chipdipru/Nermostat-RDC2-0043/RDC2-0043_BOM.pdf

RDC2-0043 BOM

количество | позиция | наименование | код товара
11 | C1, C2, C6 - C8, C10 - C15 | 0.1мкФ, 50В, 0603 | 226236018
2 | C3, C5 | 2.2мкФ, 10В, 0603 | 964476454
1 | C4 | 0.01 мкФ, 50В, 0603 | 990818187
2 | C9, C16 | 4.7 мкФ, 10 В, тип A | 6038
1 | DA1 | LP2985AIM5-3.3/NOPB | 398602252
1 | DD1 | M95640-WMN6P | 9020005380
1 | DD2 | STM32F042K6T6 | 9000240186
4 | HL2, HL4 - HL6 | TOS-F2101AMG-N-1-HF | 9000473272
1 | HL3 | TO-2013BC-PG | 9000414318
1 | R1 | не устанавливать
12 | R2 - R5, R7 - R13, R25 | 0.063Вт 0603 10 кОм, 5% | 65097
9 | R6, R15 - R22 | 0.063Вт 0603 330 Ом, 5% | 16489
1 | R14 | 0.063Вт 0603 4.7 кОм, 5% | 13832
2 | R23, R24 | 0.063Вт 0603 22 Ом, 5% | 45498
1 | SW1 | не устанавливать
4 | SW2 - SW5 | KLS7-TS3601-4.3-180 (TC-0120) | 9000336835
1 | VD1 | USBLC6-2SC6 | 9000039051
1 | VD2 | MBR0520L | 9000119271
4 | VT1 - VT4 | 2N7002.215 | 2272434975
1 | | KLS1-233-0-0-1-T (Micro USB 5S-B) | 9000144095
1 | | KLS2-300-5.00-03P-2S | 9000329448
1 | | Печатная плата RDC2-0043 | 9000508597
