chipdipru/Nermostat-RDC2-0043/RDC2-0043_sch.pdf

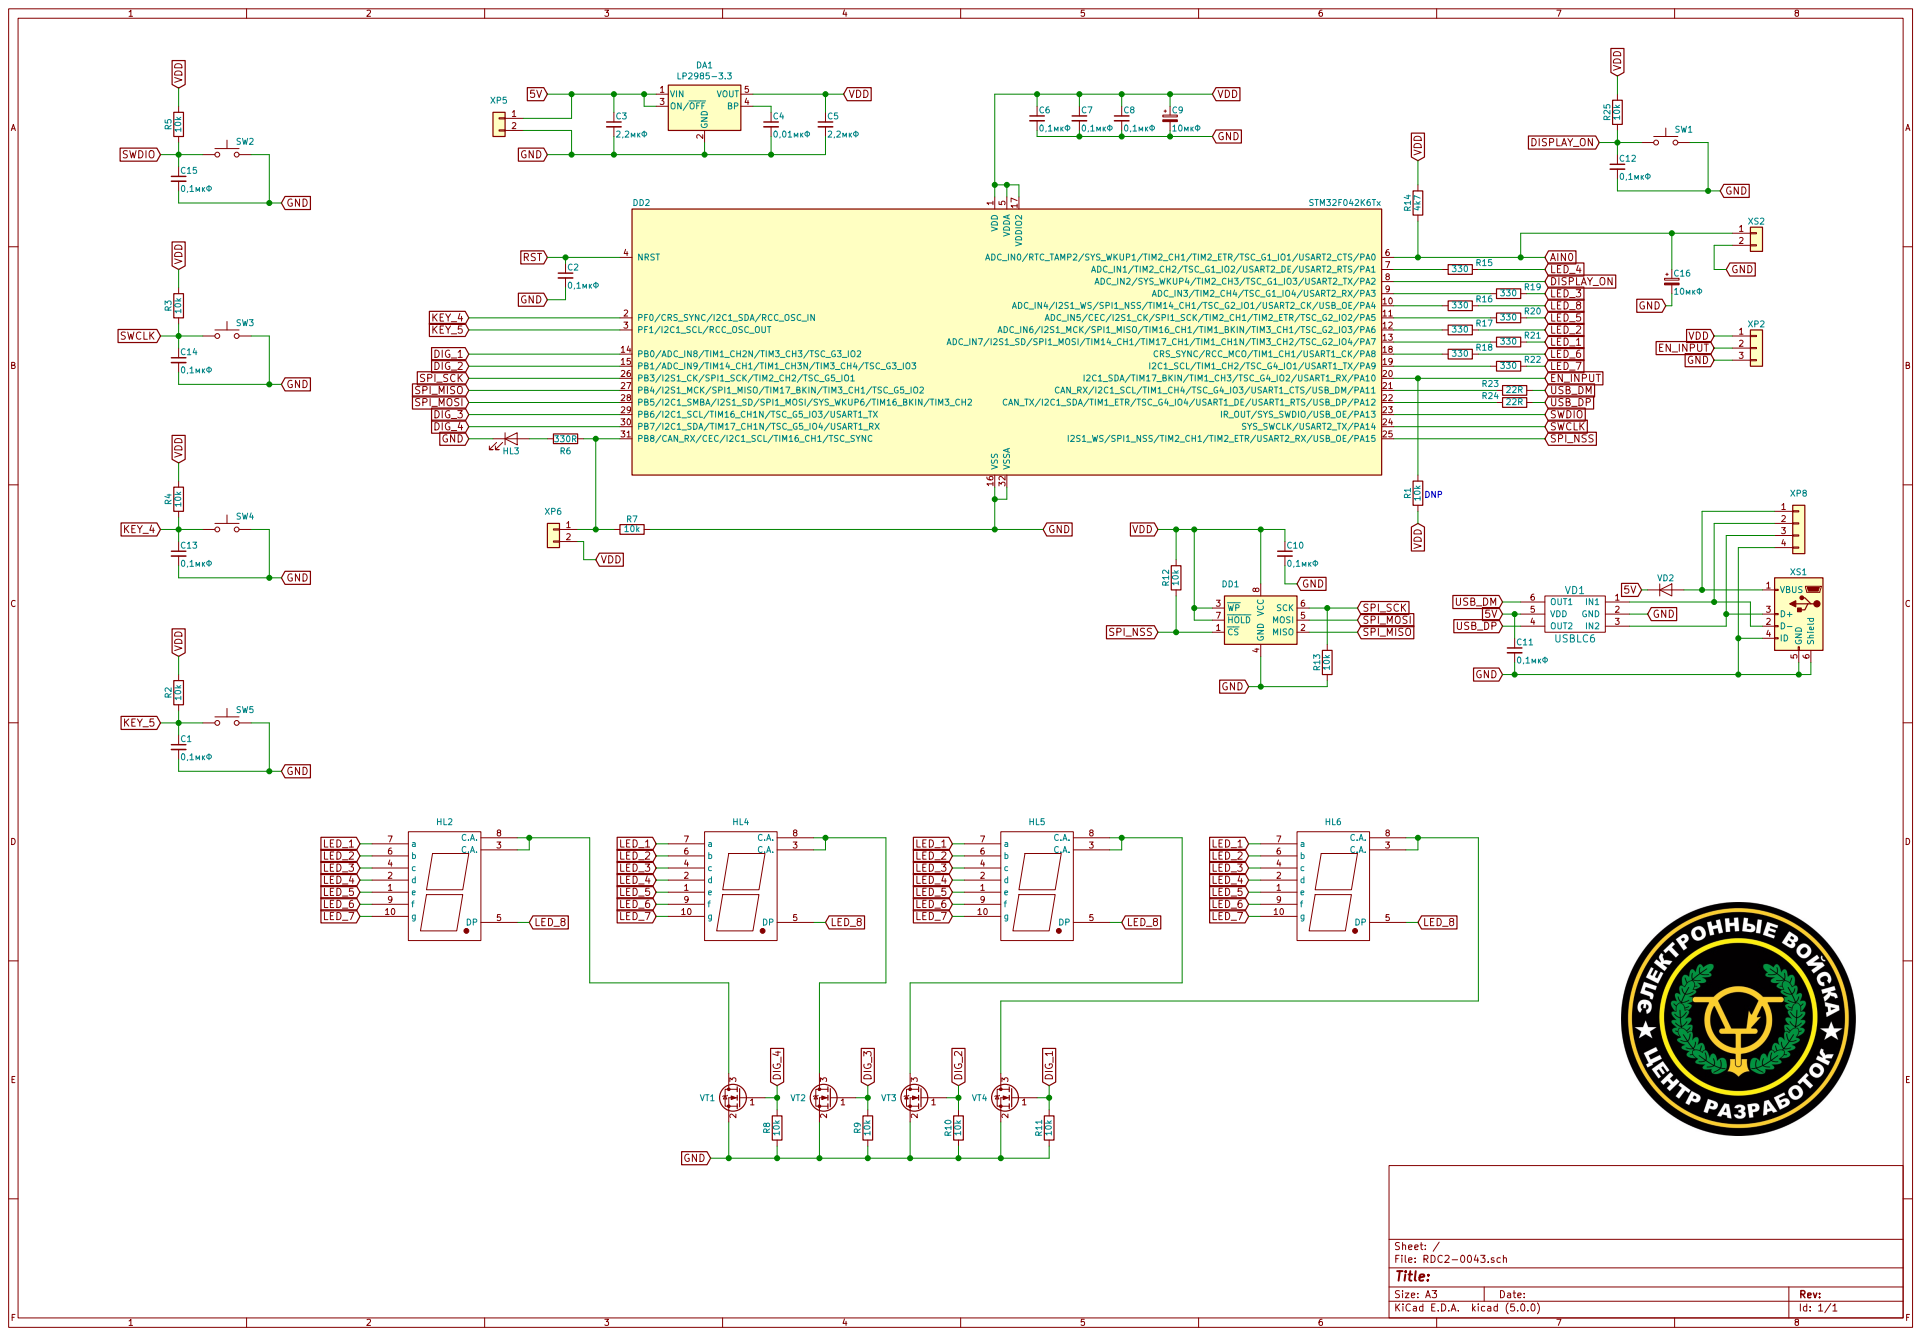
[picture p1: page 1]

2 ON/OFF 3 BP 4 VOUT 5 DA1

4 MOSI 5 SCK 6 HOLD 7 VCC

Id: 1/1 Title: File: RDC2-0043.sch Sheet: /
