chipdipru/Nermostat-RDC2-0043/(notices)

Notices in the files:
RDC2-0043/Inc/RDC2_0043_USB.h:
COPYRIGHT(c) ÇÀÎ «×ÈÏ è ÄÈÏ», 2017
RDC2-0043/Inc/UserCtrl.h:
COPYRIGHT(c) ÇÀÎ «×ÈÏ è ÄÈÏ», 2018
